KaskasR/scentty/docs/chassis_render.png

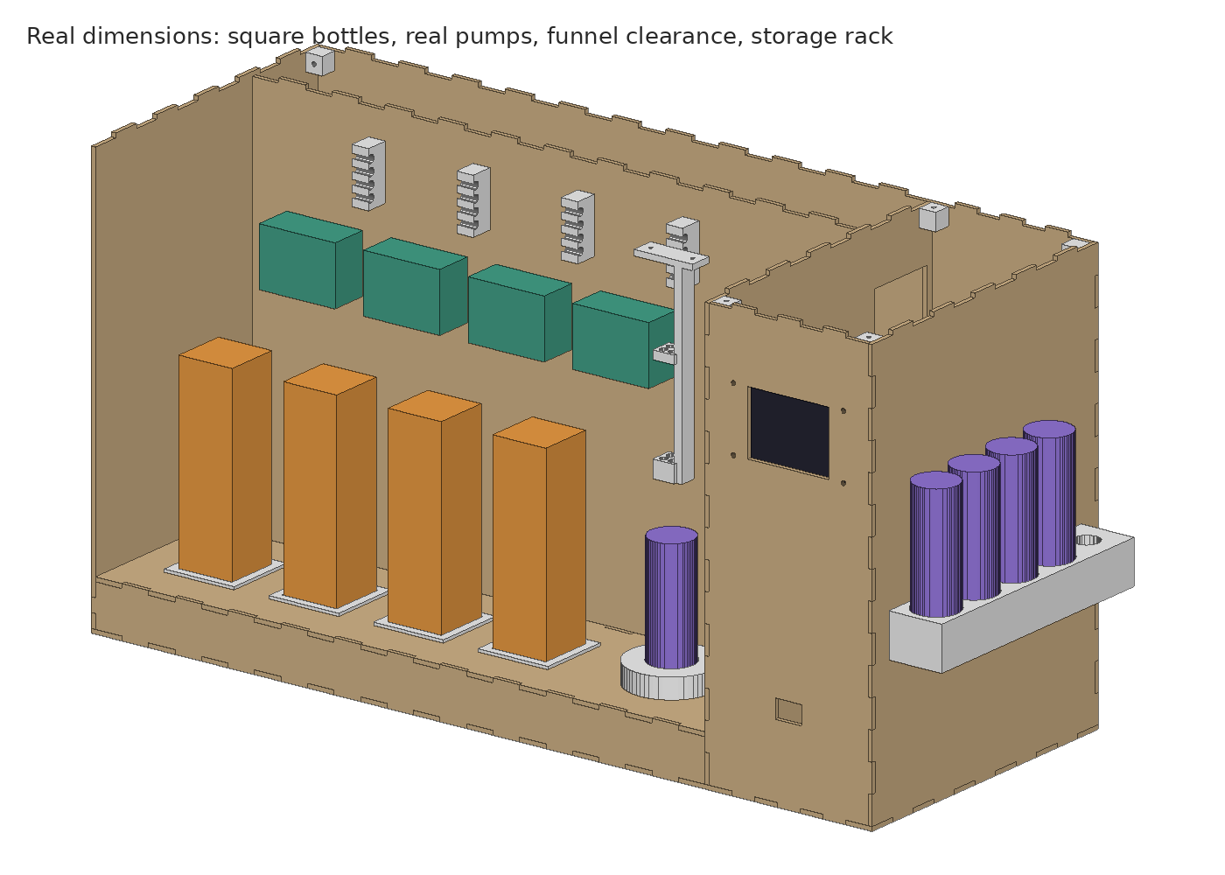
docs/chassis_render.png
