KaskasR/scentty/cad/scentty_chassis_preview.step

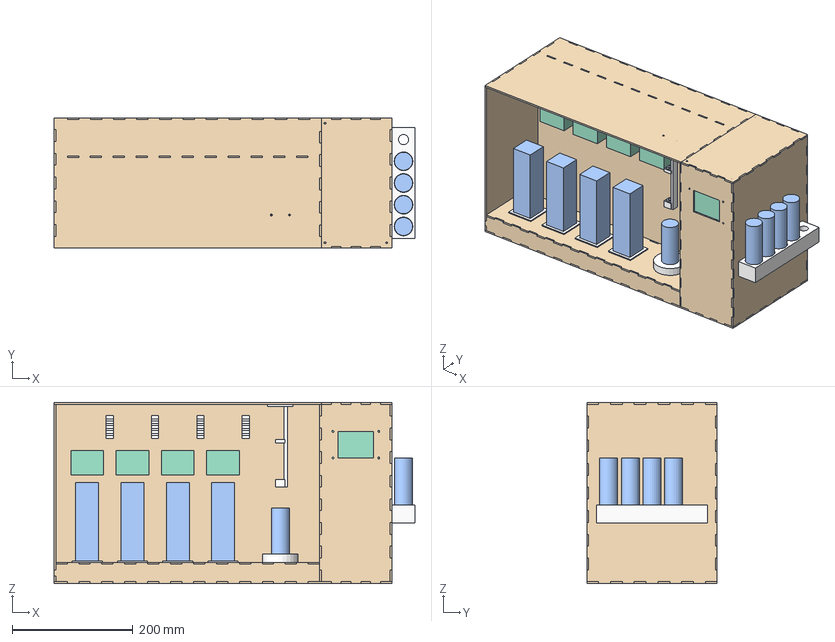
[picture p2: CAD file, 2026-11-09]
cad/scentty_chassis_preview.step
598.0 x 216.0 x 300.0 mm
Base
Left_side
Right_side
Back_screw-on
Top_wet_bay
Bay_lid_screw-on
Divider_wall
Bay_front_QR
Pump_wall
Plinth_top
Plinth_front
Plinth_back
PRINT_diffuser_cup_1
PRINT_diffuser_cup_2
PRINT_diffuser_cup_3
PRINT_diffuser_cup_4
PRINT_output_pad
PRINT_nozzle_holder
PRINT_storage_rack
PRINT_tube_clip_1
PRINT_tube_clip_2
PRINT_tube_clip_3
PRINT_tube_clip_4
PRINT_screw_block_back_1
PRINT_screw_block_back_2
PRINT_screw_block_back_3
PRINT_screw_block_back_4
PRINT_screw_block_lid_1
PRINT_screw_block_lid_2
PRINT_screw_block_lid_3
REF_bottle_1
REF_pump_head_1
REF_pump_motor_1
REF_bottle_2
REF_pump_head_2
REF_pump_motor_2
REF_bottle_3
REF_pump_head_3
REF_pump_motor_3
REF_bottle_4
REF_pump_head_4
REF_pump_motor_4
REF_stored_bottle_1
REF_stored_bottle_2
REF_stored_bottle_3
REF_stored_bottle_4
REF_2.8in_screen
REF_output_bottle
