KaskasR/scentty/(commit log)

2026-11-09 Baseline: spec, chassis CAD, pump bench test
    [scentty_chassis_preview.step]
2026-11-09 Phase 1: quiz content, scoring + blend math, threshold simulation
    - firmware/data/quiz.js: 9 questions + strength question, 7 profiles (content only)
    - firmware/data/scoring.js: tally, 10% floor shares, mL recipe in 0.1 mL steps, archetype
    - tools/simulate.js: random + persona crowds, threshold sweep, invariant checks
    - SPEC §3: record thresholds (harmony spread 0.16, single share 0.54)
2026-11-09 Phase 2: phone web app + operator page, mock mode
    - firmware/data/index.html, style.css, app.js: welcome → 26 questions → reveal
    (triangle chart, %, recipe) → get ready → making (live per-pump bars, bottle
    fill) → done; busy ("you're next", auto-retry), cancel (two taps), error
    - api.js: real client for the SPEC §5 endpoints + in-browser mock machine
    (?mock=1 | busy | error), auto-fallback when /api is unreachable
    - admin.html/js: hold-to-run prime, flush, calibration, test blend, LEDs, E-stop
    - all design decisions as CSS variables; no external resources (~100 KB total)
    - quiz.js: checkpoint lines; SPEC §5: API contract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
2026-11-09 Phase 3: firmware - AP, captive portal, API, pump state machine, calibration
    - src/pumps.cpp: non-blocking dispenser (idle/dispensing/done/error/busy),
    one pump at a time, watchdog, validation, hold-to-run, mutex vs web task
    - src/web.cpp: open AP + wildcard DNS + OS connectivity-probe redirects,
    LittleFS static app, SPEC §5 JSON API
    - src/calibration.cpp: mL/s per pump in NVS (default 1.17 = 70 mL/min)
    - huge_app partitions; bench test moved to env 'bench'
    - test_host/: 12 laptop tests of the state machine (fake clock + pins)
    - SPEC §5, CLAUDE.md updated
    [bench.cpp, calibration.cpp, calibration.h, config.h, main.cpp, pumps.cpp]
2026-11-09 Add HARDWARE.md; sync SPEC §6 and CLAUDE.md to the as-built wiring
    - HARDWARE.md: authoritative as-built wiring reference (wins over SPEC.md)
    - SPEC §6: one continuous 23-LED strip with zone lighting and brightness cap,
    all four pumps and the screen verified, pump 3 on GPIO 27, free pins
    - SPEC §5: name the verified libraries (Adafruit NeoPixel, Adafruit_ILI9341 + GFX)
    - CLAUDE.md: read HARDWARE.md after SPEC.md; LED and pin constraints
